raydiy/LokLiftController/docs/images/LokLift-Controller-03.jpg

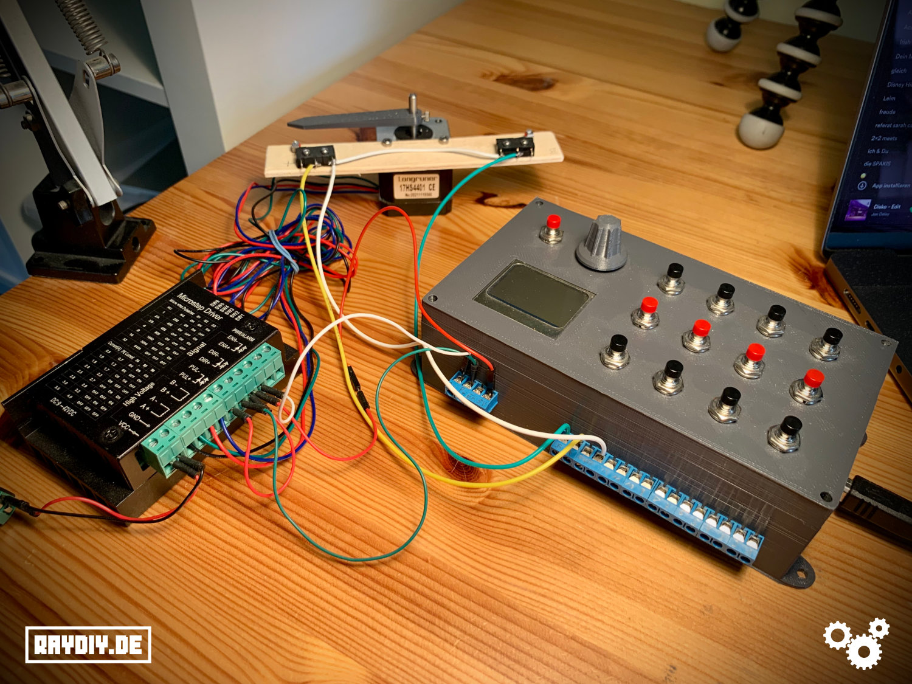
docs/images/LokLift-Controller-03.jpg
