raydiy/LokLiftController/(commit log)

2022-04-10 added calibaration and store track length value in EEPROM
2022-04-10 added motorModes
2022-06-12 Added simple acceleration to MotorMoveTo Method
2023-01-15 update der README Datei
2023-02-01 changed all rotary encoder to new ClickEncoder lib MotorSettings UI added MotoSettings editable with rotary encoder added local ClickEncoder lib added reset() method to ClickEncoder lib
    [main.cpp]
2023-02-01 added saving of motor settings to EEPROM
2023-02-01 added MOTOR_PPR to savable motor settings
2023-02-03 added new LinearMap function found a BIG problem: the values for MOTOR_PULSE_DELAY gets too big
    [main.cpp]
